ffleurey/Code-A-Pillar/Bluetooth/README.md

# Bluetooth Code-A-Pillar Block

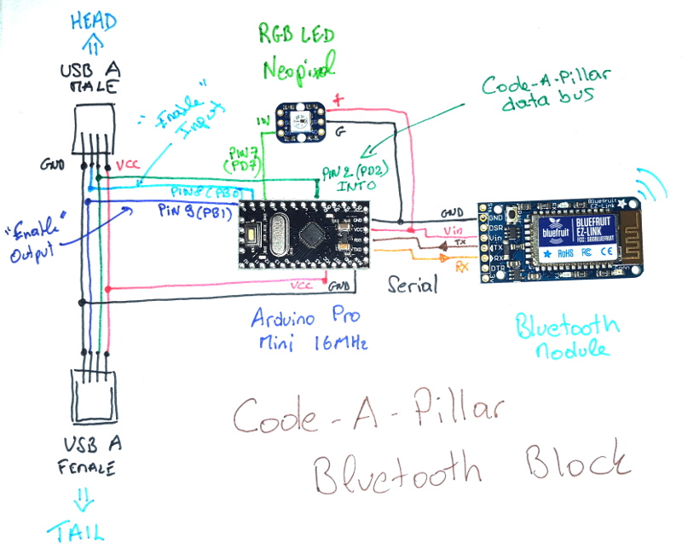
[picture p5: Bluetooth/img/wiring.jpg]
Wiring
