ffleurey/Code-A-Pillar/img/DSC_7163.jpg

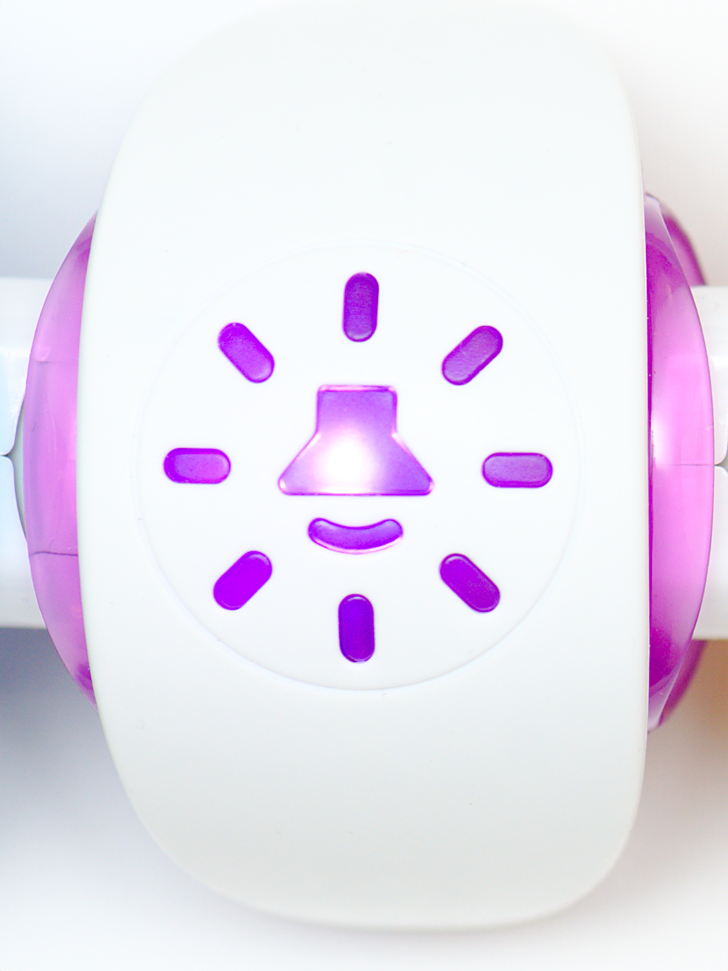
img/DSC_7163.jpg
