ffleurey/Code-A-Pillar/img/DSC_7163_01.jpg

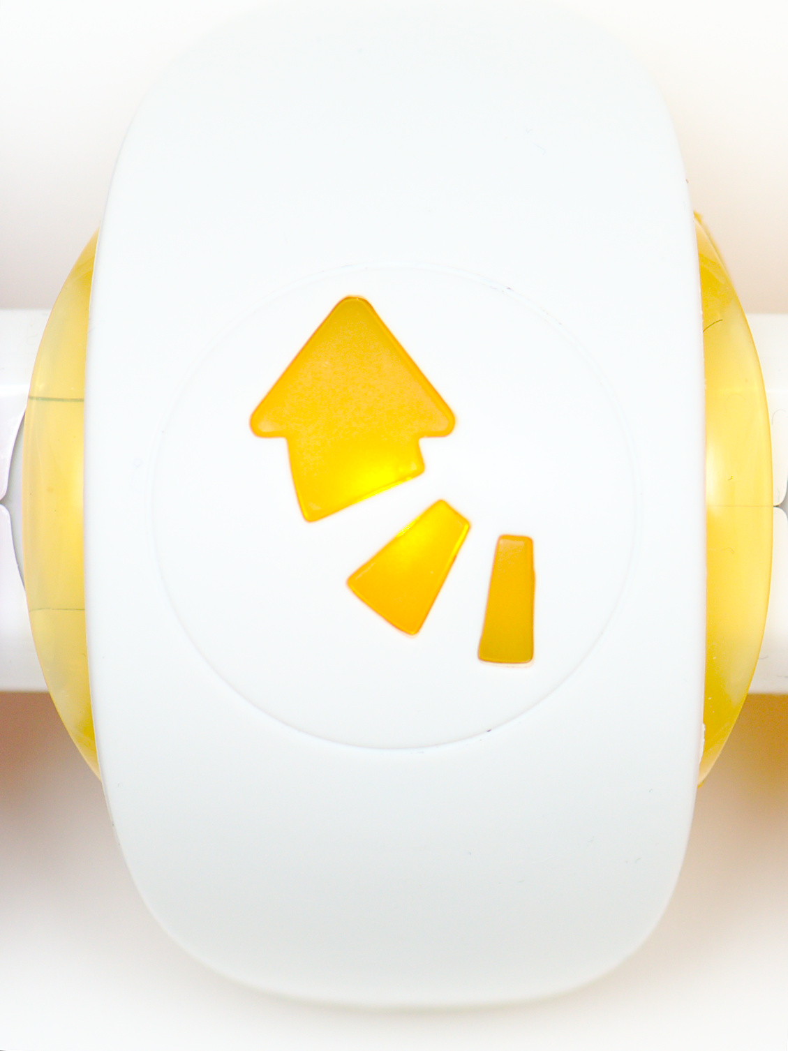
img/DSC_7163_01.jpg
