ffleurey/Code-A-Pillar/img/DSC_7163_02.jpg

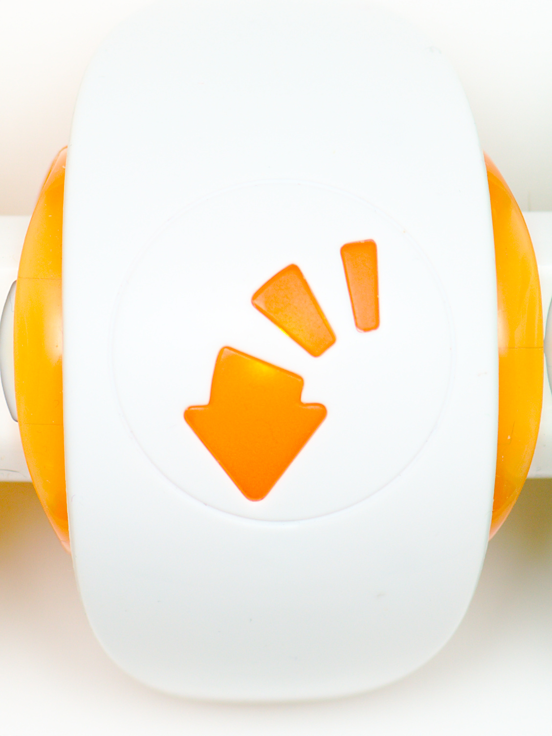
img/DSC_7163_02.jpg
