ffleurey/Code-A-Pillar/img/DSC_7163_03.jpg

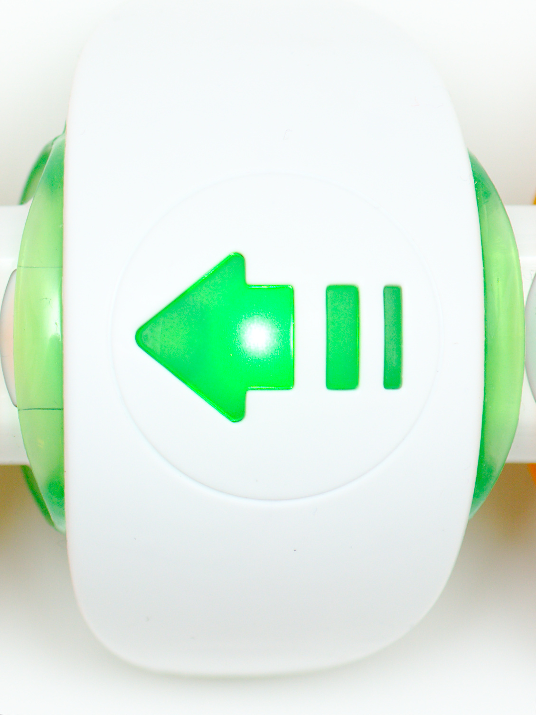
img/DSC_7163_03.jpg
