ffleurey/Code-A-Pillar/img/init/20161217_160753.jpg

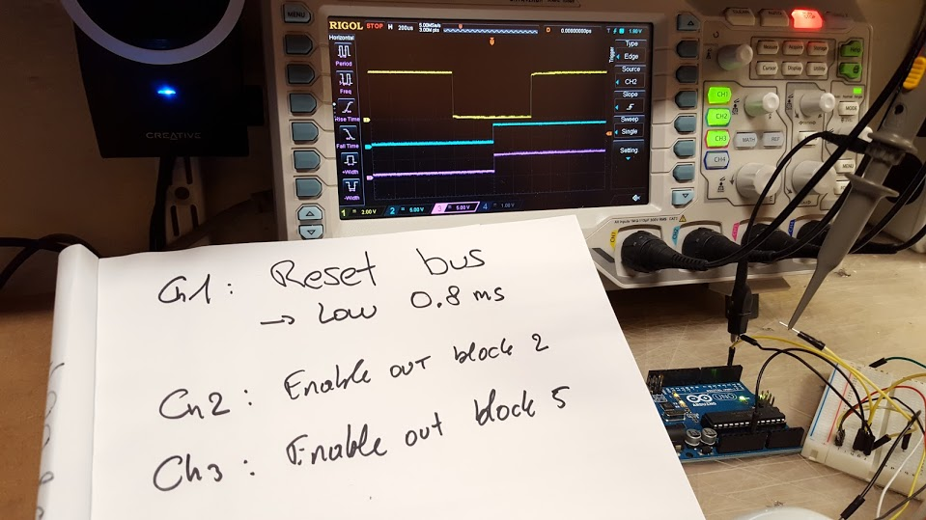
img/init/20161217_160753.jpg
