ffleurey/Code-A-Pillar/img/init/20161217_163015.jpg

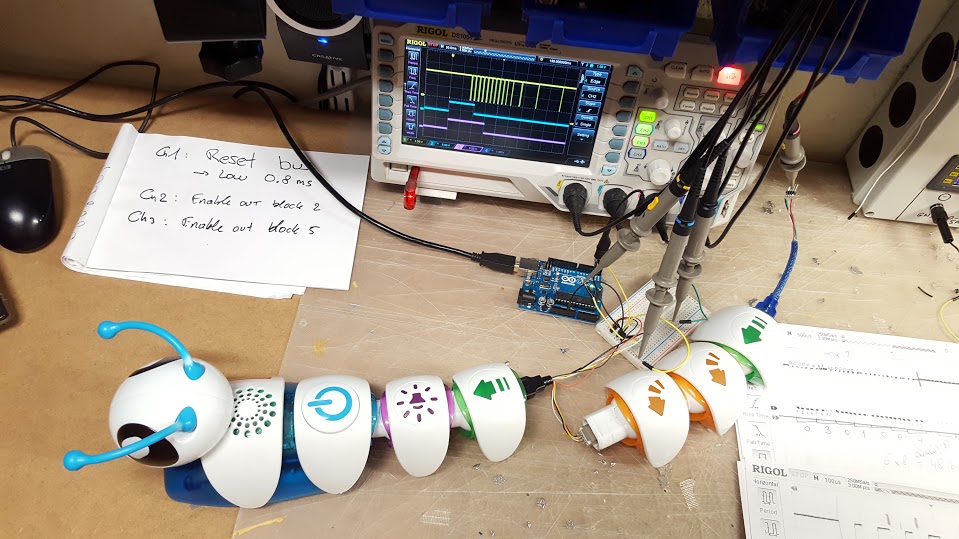
img/init/20161217_163015.jpg
