ffleurey/Code-A-Pillar/img/DS1Z_QuickPrint22.png

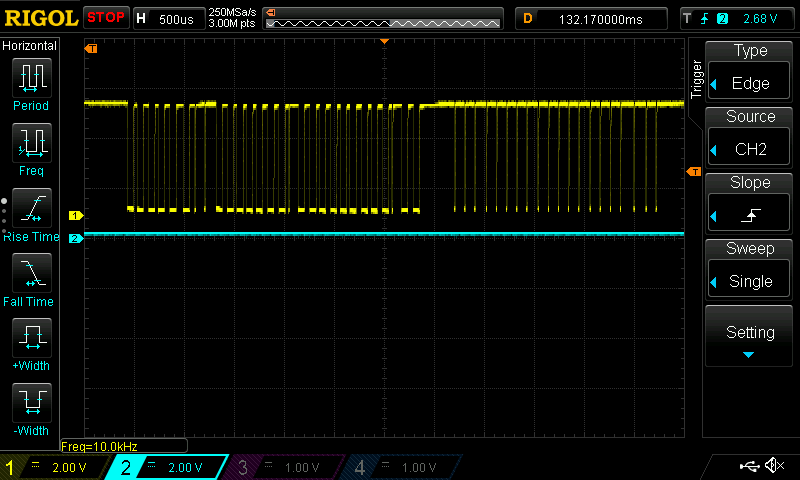
img/DS1Z_QuickPrint22.png
