ffleurey/Code-A-Pillar/img/DS1Z_QuickPrint24.png

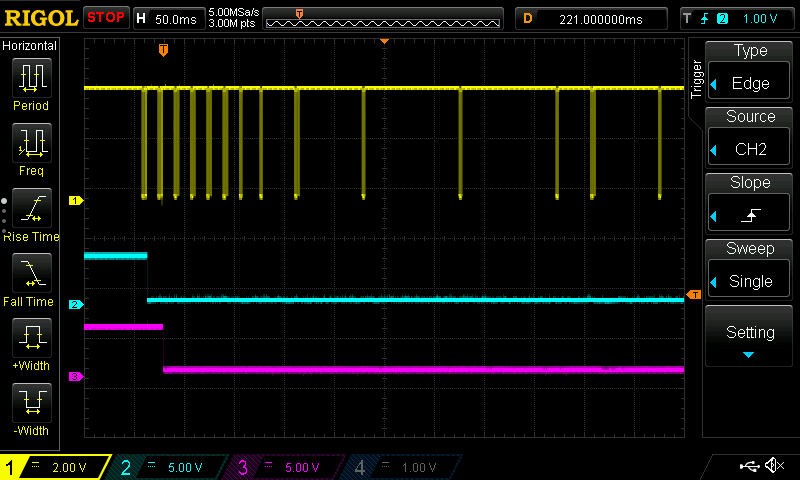
img/DS1Z_QuickPrint24.png
