ffleurey/Code-A-Pillar/img/DS1Z_QuickPrint25.png

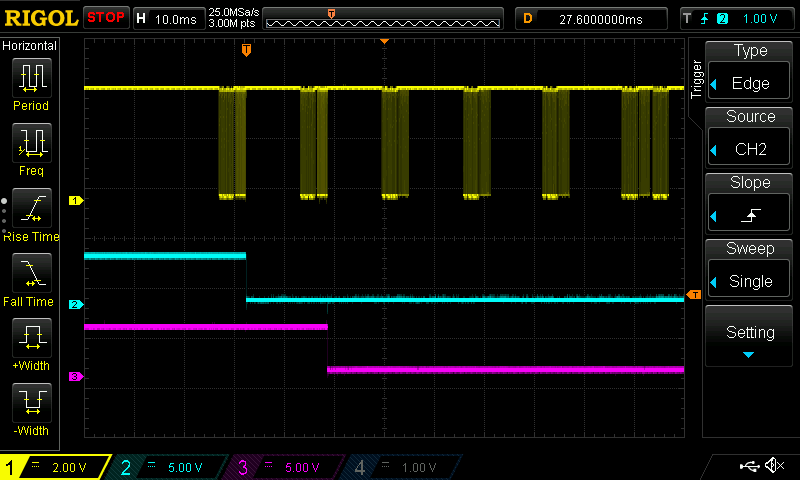
img/DS1Z_QuickPrint25.png
