ffleurey/Code-A-Pillar/img/DS1Z_QuickPrint26.png

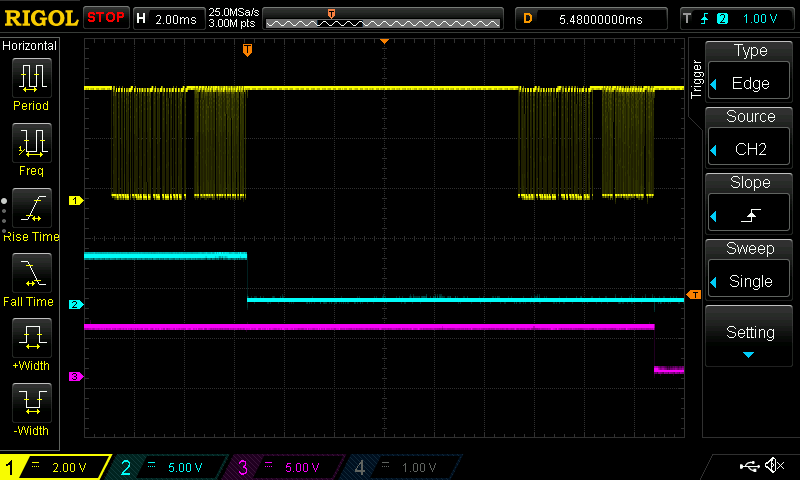
img/DS1Z_QuickPrint26.png
