ffleurey/Code-A-Pillar/img/DS1Z_QuickPrint28.png

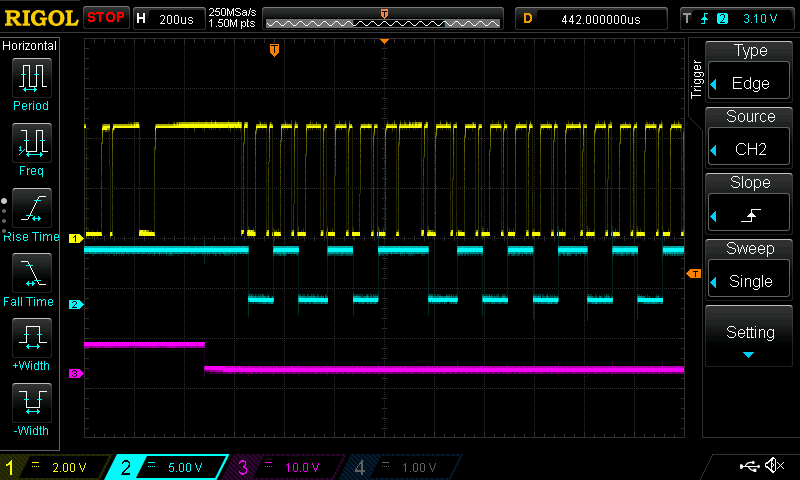
img/DS1Z_QuickPrint28.png
