ffleurey/Code-A-Pillar/img/DS1Z_QuickPrint29.png

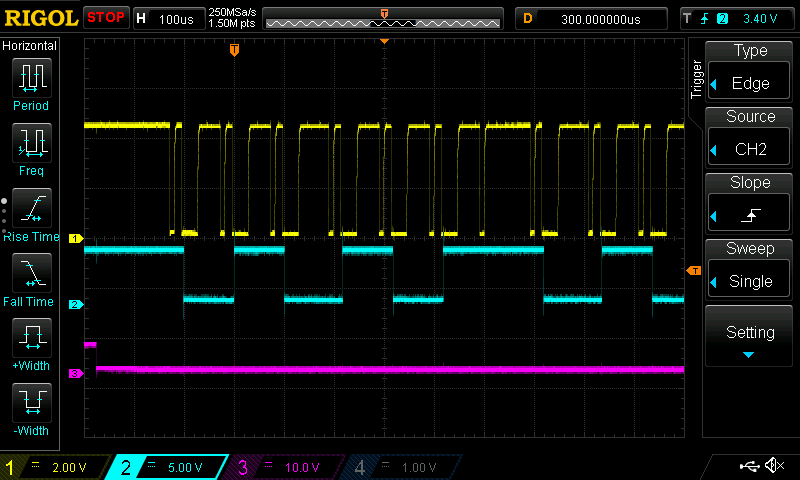
img/DS1Z_QuickPrint29.png
