ffleurey/Code-A-Pillar/img/DS1Z_QuickPrint30.png

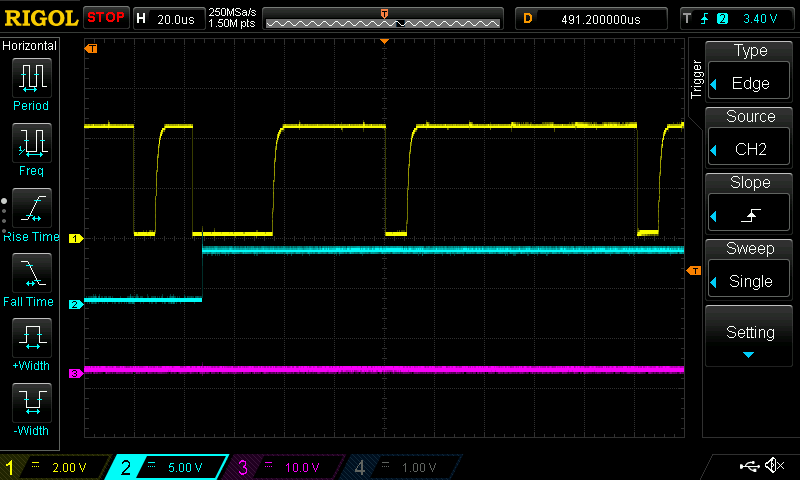
img/DS1Z_QuickPrint30.png
