ffleurey/Code-A-Pillar/img/DS1Z_QuickPrint31.png

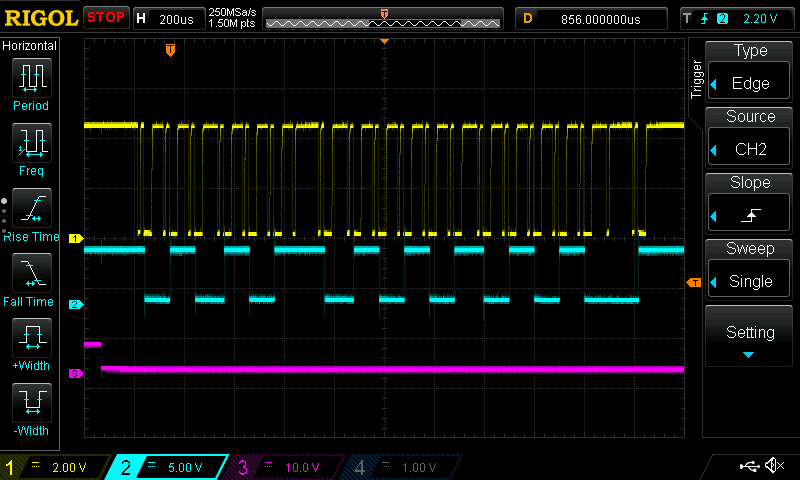
img/DS1Z_QuickPrint31.png
