ffleurey/Code-A-Pillar/img/init/DS1Z_QuickPrint34.png

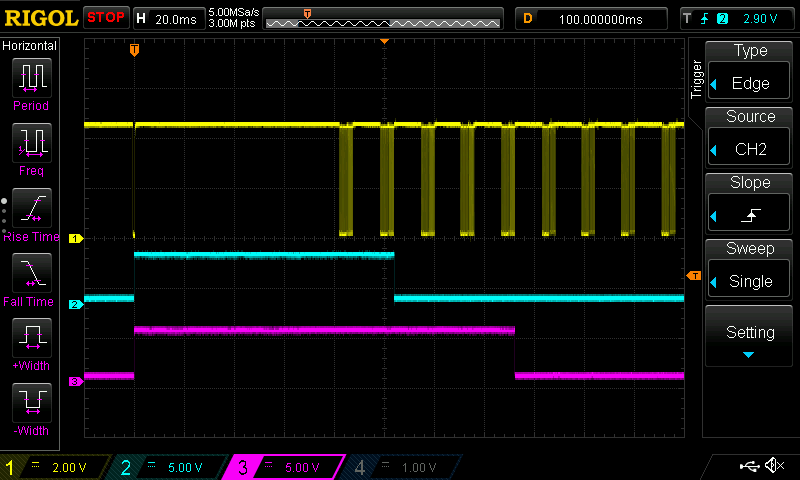
img/init/DS1Z_QuickPrint34.png
