ffleurey/Code-A-Pillar/img/init/DS1Z_QuickPrint35.png

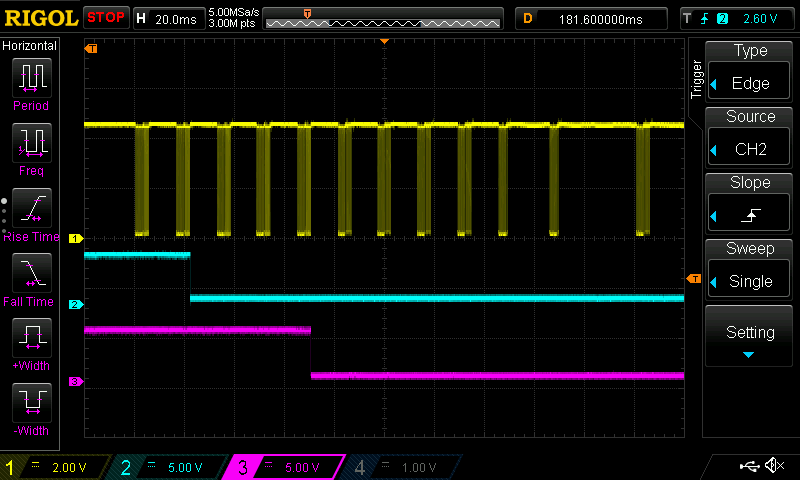
img/init/DS1Z_QuickPrint35.png
