ffleurey/Code-A-Pillar/img/init/DS1Z_QuickPrint38.png

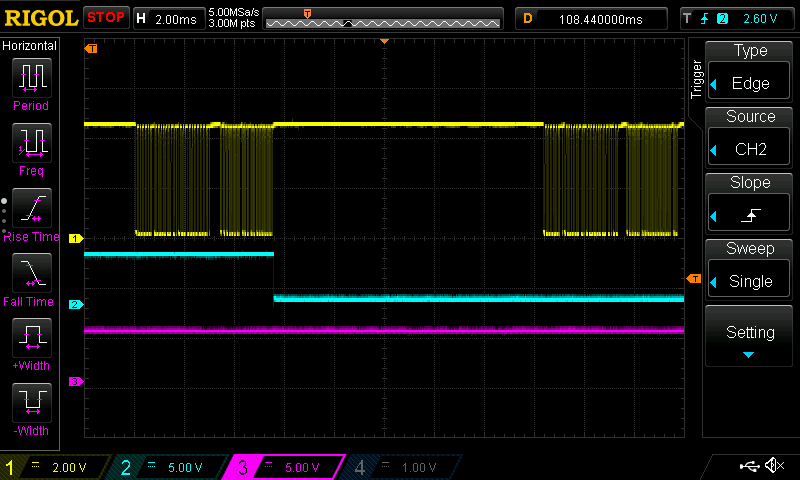
img/init/DS1Z_QuickPrint38.png
