ffleurey/Code-A-Pillar/img/init/DS1Z_QuickPrint39.png

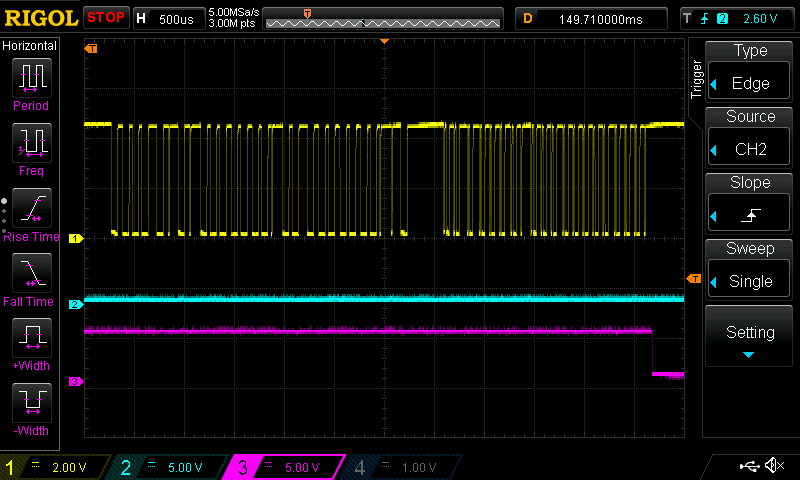
img/init/DS1Z_QuickPrint39.png
