ffleurey/Code-A-Pillar/img/init/DS1Z_QuickPrint40.png

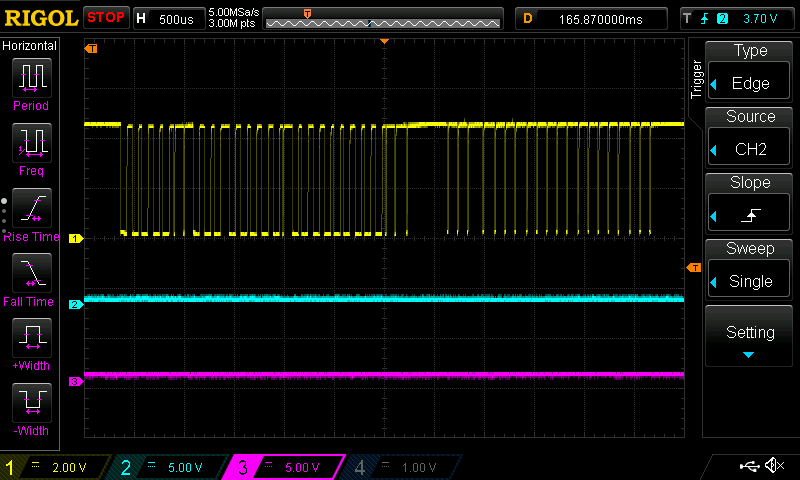
img/init/DS1Z_QuickPrint40.png
