ffleurey/Code-A-Pillar/img/init/DS1Z_QuickPrint41.png

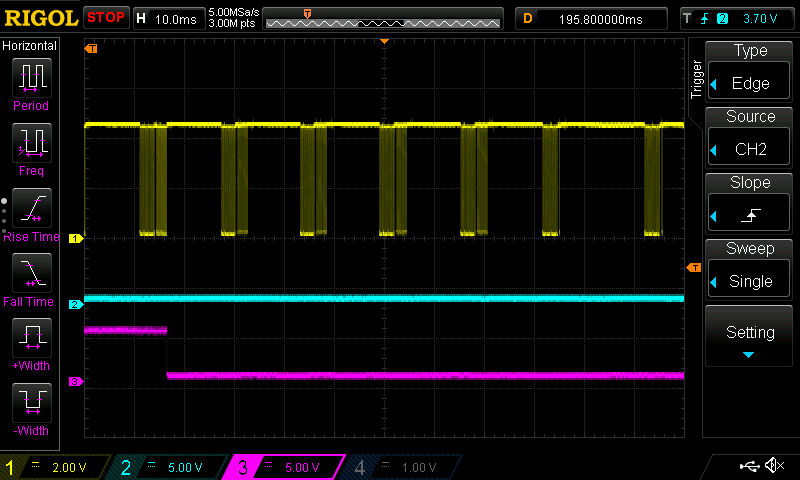
img/init/DS1Z_QuickPrint41.png
