ffleurey/Code-A-Pillar/(threads)

Thread 1 (2019-03-30):

Using a D1 mini?

smokeandlights, 2019-03-30:
More of a question than an issue:
Could your Bluetooth block sketch be used with a D1 mini (ESP8266 based Arduino compatible with Bluetooth on board)? What changes would need to be made, if not?
