ffleurey/Code-A-Pillar/(commit log)

2017-01-01 Bug fix in timer wrap around. Using div 32 prescaler istead of 8.
    [Sniff-A-Pillar.ino]
2017-01-01 Bug fix in checksum calculation
    [Sniff-A-Pillar.ino]
2017-01-01 Print brodcasts correctly
2017-01-01 Added a capture for a simple run of the pillar
    [DUMP1.txt]
2017-01-03 Wiring for a bluetooth prototype block
2017-01-07 Bluetooth sniffer prototype
